georgia-george/CAD-Files/README.md

Contains most of the CAD files made for the BACoN (and BTB) experiment at the University of New Mexico. Includes older versions of pieces that are now obsolete.
