georgia-george/CAD-Files/sipm_coords_1.png

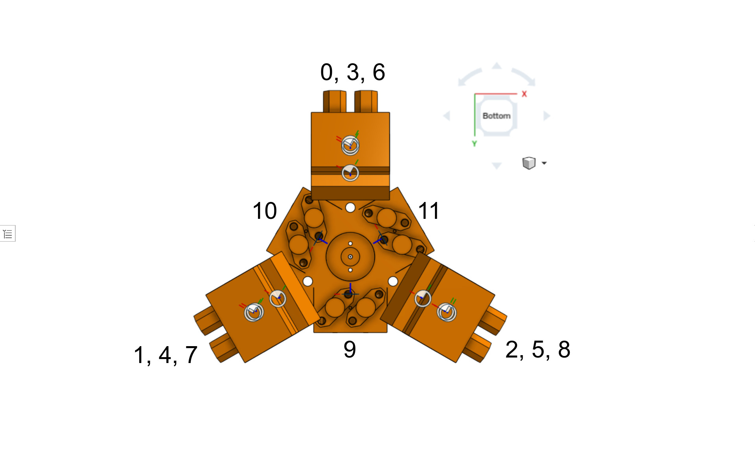
sipm_coords_1.png
