georgia-george/CAD-Files/sipm_coords_2.png

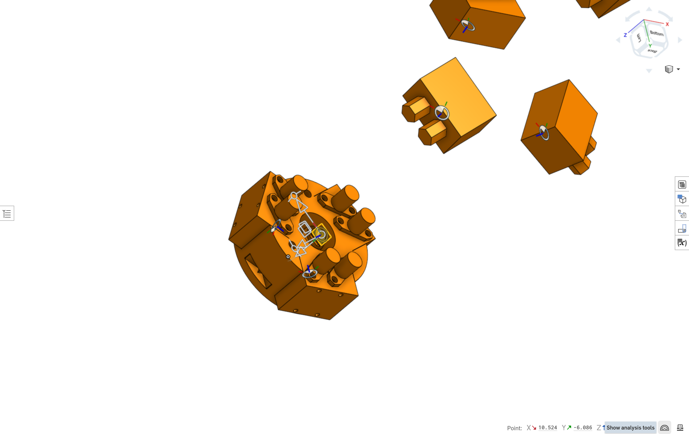
sipm_coords_2.png
