georgia-george/CAD-Files/allsipms_assembly_simplified_aluminumfoil.step

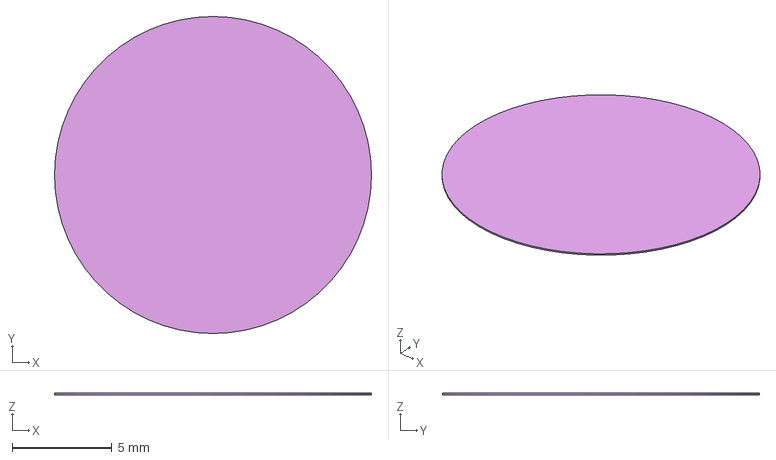
[picture p5: CAD file, 2025-08-05]
allsipms_assembly_simplified_aluminumfoil.step
15.9 x 15.9 x 0.0762 mm
