georgia-george/CAD-Files/allsipms_assembly_simplified_windows.step

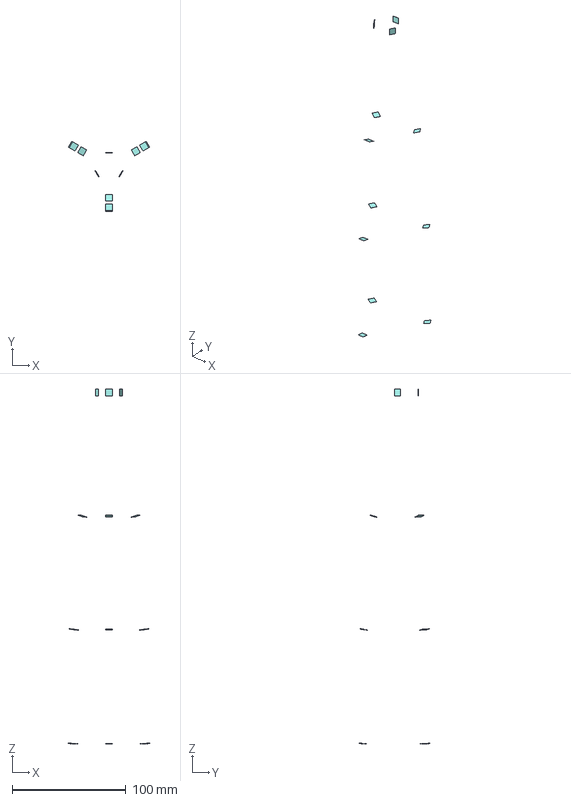
[picture p6: CAD file, 2025-08-05]
allsipms_assembly_simplified_windows.step
71.5 x 61.9 x 311.9 mm
rod3_sensor2_sipm
rod1_sensor3_sipm
rod1_sensor0_sipm
rod2_sensor1_sipm
rod1_sensor6_sipm
rod3_sensor3_sipm
TriggerSiPM_2_sipm
rod3_sensor5_sipm
TriggerSiPM_3_sipm
TriggerSiPM_1_sipm
rod2_sensor4_sipm
rod2_sensor2_sipm
