georgia-george/CAD-Files/new_holder_copper.step

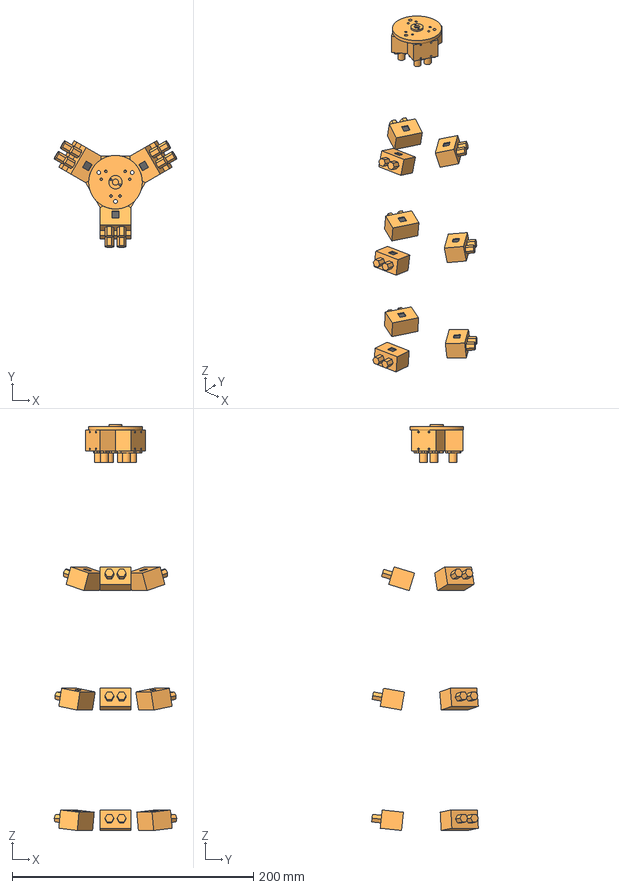
[picture p9: CAD file, 2025-08-05]
new_holder_copper.step
101.7 x 88.5 x 336.4 mm
rod3_sensor5_box
rod2_sensor4_box
rod1_sensor0_box
SiPM BOX V2 FOR RADIAL ASSEMBLY W SQUARE OPENING.step
rod3_sensor3_box
rod1_sensor6_box
rod1_sensor3_box
rod3_sensor2_box
rod2_sensor1_box
rod2_sensor2_box
