georgia-george/CAD-Files/adapter for 3 coils.step

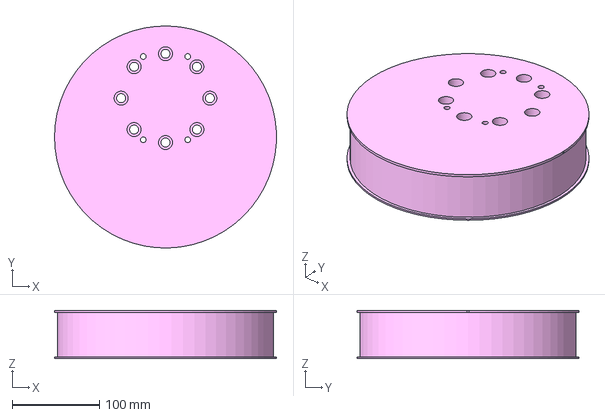
[picture p11: CAD file, 2025-08-05]
adapter for 3 coils.step
254.0 x 253.9 x 55.2 mm
