georgia-george/CAD-Files/new_holder_alfoil.step

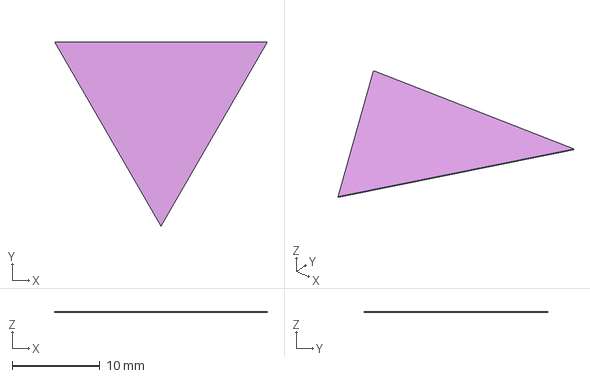
[picture p12: CAD file, 2025-08-05]
new_holder_alfoil.step
24.2 x 21.0 x 0.0762 mm
