georgia-george/CAD-Files/(list of files, cad)

Other CAD files:
new_holder_windows.step
